littlebitselectronics/HDK-hardware-dev-manual/Design/Templates for PRD/x##-moduleName-PRD.xls

 | This is a Product Requirements Document (PRD) template. The purpose of the PRD is to give engineers a set of features to design to and metrics to determine if a final prototype behaves in an acceptable manner. The information you put here should be closely related to how your prototype works now, and how you want it to work before we ship it. Please delete the contents of this cell, and replace text in RED with your own information. Refer to the examples/ folder if you need an example, and contact us with any questions!
PART NUMBER: | x##-bitName
PRD REVISION: | rev1
PRD CHANGE LOG:
DATE CODE: | DESCRIPTION OF CHANGE: | AUTHOR:
Today's date, formatted like YYMMDD. For example, 4-2-2015 becomes 150402. | Initial revision | Your initials
OVERVIEW:
PRODUCT TYPE: | DESCRIPTION OF PRODUCT: | AUTHOR:
INPUT, OUTPUT, WIRE or POWER. | A brief summary of what the bit does. Should touch on how it interacts with bits before and after it, each mode if it has multiple modes, behavior of any user input (buttons, switches, etc.) and indicators (LEDs, etc.), and anything else you feel is necessary in order to tell someone exactly what should happen when they use the bit. | Your initials
FEATURE LIST:
PRIORITY: | DESCRIPTION OF FEATURE: | AUTHOR: | FEATURE REQUESTED BY:
1 | A more detailed enumeration of each feature described above goes here. Separate them by category (input 1, input 2, output, switch, button, LED, etc…) and prioritize them by what is most essential to the core functionality of the bit. Add as many rows as necessary. | Your initials | Your initials
2
3, etc…
CRITICAL COMPONENTS
PRIORITY: | DESCRIPTION OF FEATURE: | AUTHOR:
1 | A numbered list of all parts critical to the functionality of the Bit that may not be easily substituted or may have long lead times for ordering. | Your initials
2,etc…
MECH. REQUIREMENTS:
PARAMETER: | REQUIREMENT: | AUTHOR:
SIZE: | Bit size. Refer to HDK-eagle-templates-libraries/Eagle Templates for SCH and BRD/Standard Size Reference.pdf. Acceptable values for this field are SMALL, MEDIUM, LARGE, XLARGE, XLARGEWIDE, or XXLARGEWIDE | Your initials
INPUT: | How many input bitSnaps there are. Input bitSnaps are male, so write, for example, ONE MALE BITSNAP | Your initials
OUTPUT: | How many output bitSnaps there are, i.e. ONE FEMALE BITSNAP | Your initials
OTHER: | Any other mechanical considerations, i.e. electrode for alligator clip attachment, motor mount, etc. | Your initials
ELECT. REQUIREMENTS:
PARAMETER: | REQUIREMENT:
INPUT IMPEDANCE: | >=1MEG
OUTPUT IMPEDANCE: | <100OHMS
OUTPUT DYNAMIC RANGE: | 40dB
INPUT DYNAMIC RANGE: | 60dB
IDLE CURRENT: | TBD
MAX CURRENT: | TBD
MAX SUPPLY VOLTAGE: | 5.5
MIN SUPPLY VOLTAGE: | 4
DESIGN REQUIREMENTS:
PARAMETER: | REQUIREMENT: | AUTHOR:
1 | Protection from ESD | GML
2 | Current limiting resistors on IC inputs | GML
3 | Bypass caps on all IC supplies | GML
4 | No bypass caps connected directly to signal line | GML
5 | Ferrite bead in series with Vcc. No components connected directly to external Vcc line. | SMK
6 | Output bitSnap passes input signal through (OUTPUT bits only, remove this for other types) | GML
ACCESSORIES:
QTY: | DESCRIPTION OF ACCESSORY: | AUTHOR:
Quantity required | Any accessories that go with your bit, i.e. interface cable, etc. | Your initials
RELATED PRODUCTS:
PRODUCT: | DESCRIPTION OF RELATIONSHIP: | AUTHOR:
 | Internal use only
LAYOUT PROPOSALS
 | Internal use only
