littlebitselectronics/HDK-hardware-dev-manual/Design/Templates for BOM/x##-moduleName-BOM-XXXXXX.xlsx

Ops PN: | Leave blank
Eng PN: | x##-bitName
Revision | Today's date in the form YYMMDD
Date | Today's date in a more normal format
 |  | This is a Bill of Materials (BOM) template. The purpose of the BOM is to enumerate each component that makes up the PCB assembly (PCBA) of your bit. Anything that is attached to the board in any way goes on the BOM. Please delete the contents of this cell, and replace text in RED with your own information. When you're done, change the six X's at the end of the filename to today's date in the format YYMMDD. Refer to the examples/ folder if you need an example, and contact us with any questions!
ITEM | Ops PN | Description | Rev | Qty Per | MFG | Mfr Part Number | Ref Loc | SUB ALLOWED?
1 |  | Little Bits Connector - Male - Pink (replace this with the proper color if necessary) | v0.3 | 1 | AUK |  | BSM1 | NO
2 |  | Little Bits Connector - Female - Pink (replace this with the proper color if necessary) | v0.3 | 1 | AUK |  | BSF1 | NO
3 |  | DWG PCB, FR4, Lead Free, 2 layer, white solder mask, purple legend | rev1 | 1 | GOLDENSHINE | N/A | N/A | NO
4, etc… | Leave this column blank | Add rows for all of your components. Every distinct manufacturer part number gets its own row. Write a description of the part here. | na | Qty of item per bit | The manufacturer of this component | The manufacturer part number (MPN) of this component | Reference locators for each instance of this component on the board. (i.e. C1, C2, …) | Generally yes for resistors and capacitors, no for most other components
NOTES:
All material is lead-free or RoHs compliant. Supplier to certify compliance and maintain records on all materials purchased.
Any additional notes you need to add go here
REVISION HISTORY
Date | REV | DESCRIPTION
Today's date | Today's date in the form YYMMDD | Initial BOM
APPROVALS
Initials | Date
Don't worry about this section
