littlebitselectronics/HDK-hardware-dev-manual/Design/Eagle Templates for SCH and BRD/Custom Templates/LB_BIT_1IN_2OUT-XXXL-v03(1_1x)-Template/LB_BIT_1IN_2OUT-XXXL-v03(1_1x).brd

## EAGLE design Design/Eagle Templates for SCH and BRD/Custom Templates/LB_BIT_1IN_2OUT-XXXL-v03(1_1x)-Template/LB_BIT_1IN_2OUT-XXXL-v03(1_1x).brd (2014-09-02, last stored version)

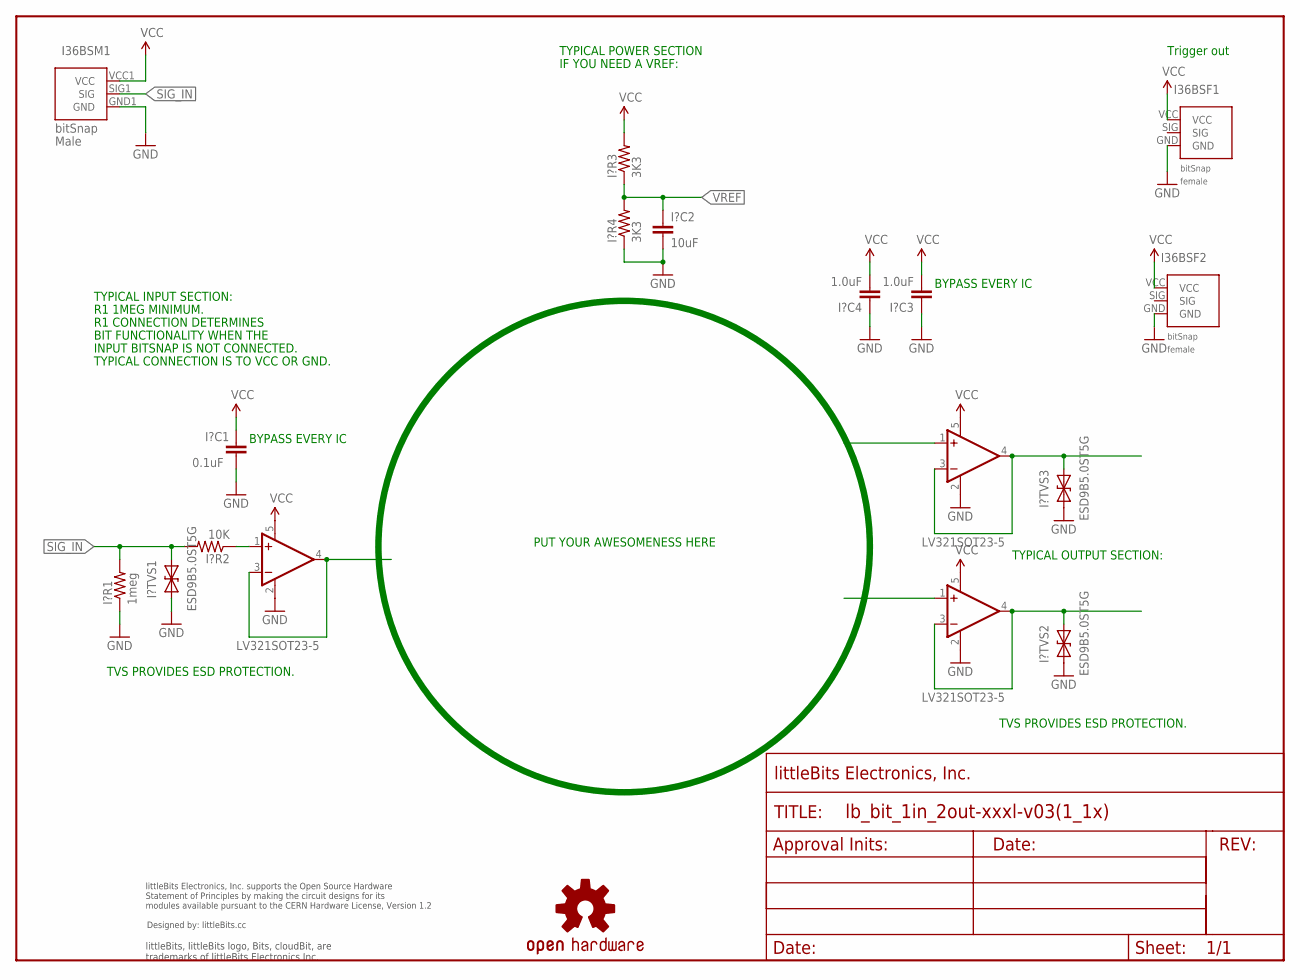
[picture p13: schematic LB_BIT_1IN_2OUT-XXXL-v03(1_1x).sch]

Parts:
FRAME1: FRAME-LETTER; FABDWG01-OHW
I36BSF1, I36BSF2: BITSNAP_V03_FEMALE
I36BSM1: BITSNAP_V03_MALE
I?C1: 0.1uF; CAP-0603
I?C2: 10uF; CAP-0603
I?C3, I?C4: 1.0uF; CAP-0603
I?R1: 1meg; RES-0603
I?R2: 10K; RES-0603
I?R3, I?R4: 3K3; RES-0603
I?TVS1, I?TVS2, I?TVS3: ESD9B5.0ST5G; SOD-923
U1, U2, U3: LV321SOT23-5; SOT23-5
U$1: OSHW-LOGOL; OSHW-LOGO-L
U$3: OSHWCREDIT

Connections:
GND: I36BSF1.GND, I36BSF2.GND, I36BSM1.GND1 (GND), I?C1.2, I?C2.2, I?C3.1, I?C4.1, I?R1.1, I?R4.1, I?TVS1.1 (A), I?TVS2.1 (A), I?TVS3.1 (A), U1.2 (V-), U2.2 (V-), U3.2 (V-)
unnamed: U1.3 (-IN), U1.4 (OUT)
unnamed: I?R2.1, U1.1 (+IN)
SIG_IN: I36BSM1.SIG1 (SIG), I?R1.2, I?R2.2, I?TVS1.2 (C)
SIG_OUT: I?TVS2.2 (C), U2.3 (-IN), U2.4 (OUT)
SIG_OUT1: I?TVS3.2 (C), U3.3 (-IN), U3.4 (OUT)
VCC: I36BSF1.VCC, I36BSF2.VCC, I36BSM1.VCC1 (VCC), I?C1.1, I?C3.2, I?C4.2, I?R3.2, U1.5 (V+), U2.5 (V+), U3.5 (V+)
VREF: I?C2.1, I?R3.1, I?R4.2

Notes on the sheet:
Trigger out
R1 1MEG MINIMUM.
R1 CONNECTION DETERMINES
BIT FUNCTIONALITY WHEN THE
INPUT BITSNAP IS NOT CONNECTED.
TYPICAL CONNECTION IS TO VCC OR GND.
TVS PROVIDES ESD PROTECTION.
TYPICAL INPUT SECTION:
TYPICAL POWER SECTION
IF YOU NEED A VREF:
PUT YOUR AWESOMENESS HERE
BYPASS EVERY IC
TYPICAL OUTPUT SECTION:

Board: 2 copper layers, 21 parts (14 on the bottom side), 8 nets, no tracks yet.

Other parts of the board:
U$17: OSHW_FILLX150_NOTEXT
