littlebitselectronics/HDK-hardware-dev-manual/Design/Eagle Templates for SCH and BRD/Custom Templates/LB_BIT_3IN_3OUT-LARGE-v03(1_1x)-Template/LB_BIT_3IN_3OUT-LARGE-v03(1_1x).brd

## EAGLE design Design/Eagle Templates for SCH and BRD/Custom Templates/LB_BIT_3IN_3OUT-LARGE-v03(1_1x)-Template/LB_BIT_3IN_3OUT-LARGE-v03(1_1x).brd (2014-09-02, last stored version)

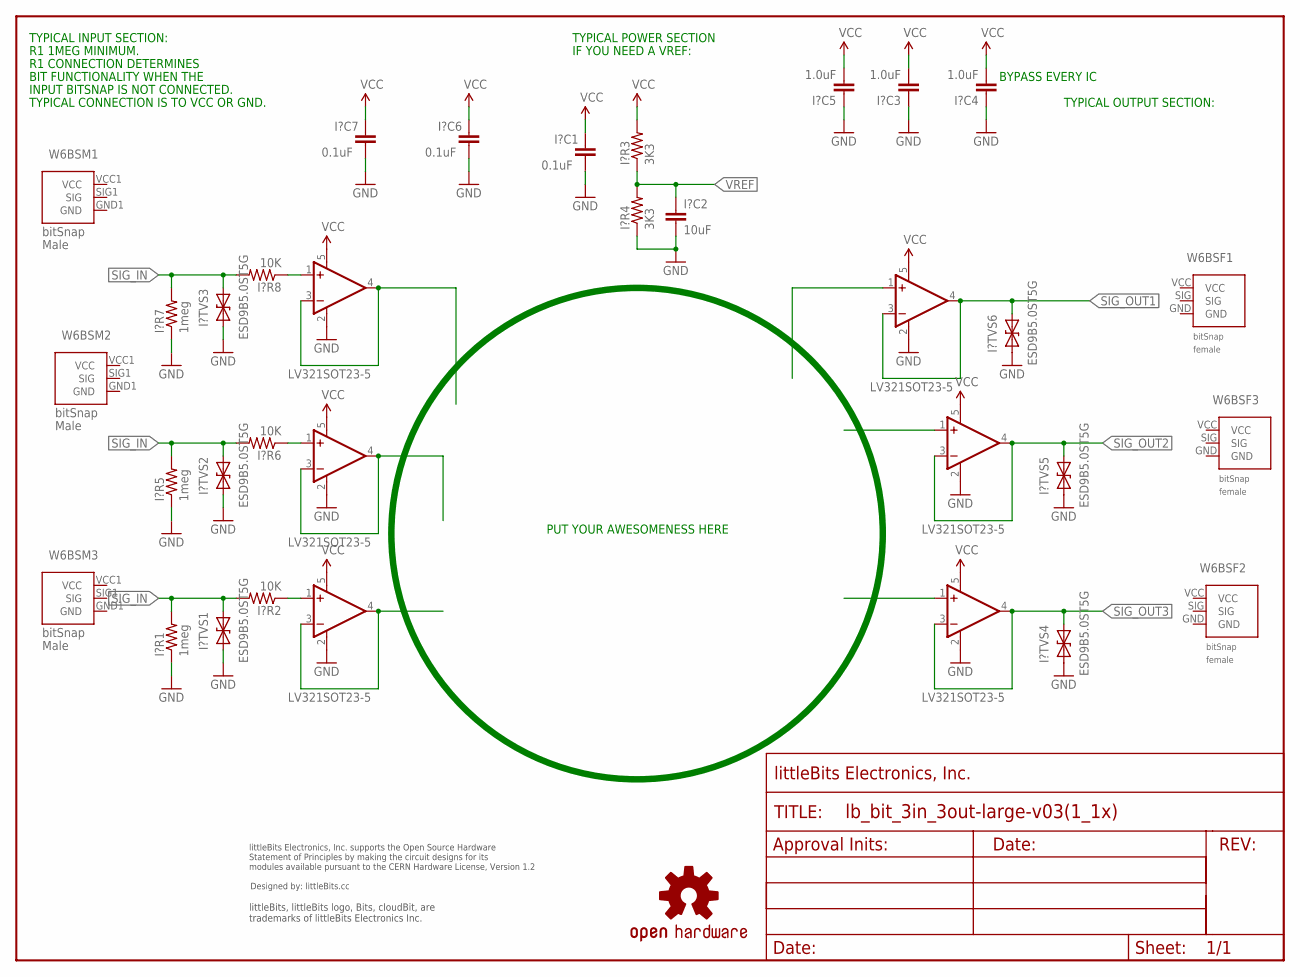
[picture p14: schematic LB_BIT_3IN_3OUT-LARGE-v03(1_1x).sch, i/o filters]

Parts:
FRAME1: FRAME-LETTER; FABDWG01-OHW
I?C1, I?C6, I?C7: 0.1uF; CAP-0603
I?C2: 10uF; CAP-0603
I?C3, I?C4, I?C5: 1.0uF; CAP-0603
I?R1, I?R5, I?R7: 1meg; RES-0603
I?R2, I?R6, I?R8: 10K; RES-0603
I?R3, I?R4: 3K3; RES-0603
I?TVS1, I?TVS2, I?TVS3, I?TVS4, I?TVS5, I?TVS6: ESD9B5.0ST5G; SOD-923
U1, U2, U3, U4, U5, U6: LV321SOT23-5; SOT23-5
U$1: OSHWCREDIT
U$70: OSHW-LOGOL; OSHW-LOGO-L
W6BSF1, W6BSF2, W6BSF3: BITSNAP_V03_FEMALE
W6BSM1, W6BSM2, W6BSM3: BITSNAP_V03_MALE

Connections:
GND: I?C1.2, I?C2.2, I?C3.1, I?C4.1, I?C5.1, I?C6.2, I?C7.2, I?R1.1, I?R4.1, I?R5.1, I?R7.1, I?TVS1.1 (A), I?TVS2.1 (A), I?TVS3.1 (A), I?TVS4.1 (A), I?TVS5.1 (A), I?TVS6.1 (A), U1.2 (V-), U2.2 (V-), U3.2 (V-), U4.2 (V-), U5.2 (V-), U6.2 (V-)
unnamed: I?R2.1, U1.1 (+IN)
unnamed: U1.3 (-IN), U1.4 (OUT)
unnamed: U2.3 (-IN), U2.4 (OUT)
unnamed: I?R6.1, U2.1 (+IN)
unnamed: U3.3 (-IN), U3.4 (OUT)
unnamed: I?R8.1, U3.1 (+IN)
SIG_IN: I?R1.2, I?R2.2, I?R5.2, I?R6.2, I?R7.2, I?R8.2, I?TVS1.2 (C), I?TVS2.2 (C), I?TVS3.2 (C)
SIG_OUT1: I?TVS6.2 (C), U6.3 (-IN), U6.4 (OUT)
SIG_OUT2: I?TVS5.2 (C), U5.3 (-IN), U5.4 (OUT)
SIG_OUT3: I?TVS4.2 (C), U4.3 (-IN), U4.4 (OUT)
VCC: I?C1.1, I?C3.2, I?C4.2, I?C5.2, I?C6.1, I?C7.1, I?R3.2, U1.5 (V+), U2.5 (V+), U3.5 (V+), U4.5 (V+), U5.5 (V+), U6.5 (V+)
VREF: I?C2.1, I?R3.1, I?R4.2

Notes on the sheet:
R1 1MEG MINIMUM.
R1 CONNECTION DETERMINES
BIT FUNCTIONALITY WHEN THE
INPUT BITSNAP IS NOT CONNECTED.
TYPICAL CONNECTION IS TO VCC OR GND.
TYPICAL INPUT SECTION:
TYPICAL POWER SECTION
IF YOU NEED A VREF:
PUT YOUR AWESOMENESS HERE
TYPICAL OUTPUT SECTION:
BYPASS EVERY IC

Board: 2 copper layers, 37 parts (27 on the bottom side), 13 nets, no tracks yet.

Other parts of the board:
U$5: OSHW_FILLX150_NOTEXT
