littlebitselectronics/HDK-hardware-dev-manual/Design/Eagle Templates for SCH and BRD/Custom Templates/LB_BIT_WIRE-v03(1_1x)-Template/LB_BIT_WIRE-v03(1_1x).brd

## EAGLE design Design/Eagle Templates for SCH and BRD/Custom Templates/LB_BIT_WIRE-v03(1_1x)-Template/LB_BIT_WIRE-v03(1_1x).brd (2014-09-02, last stored version)

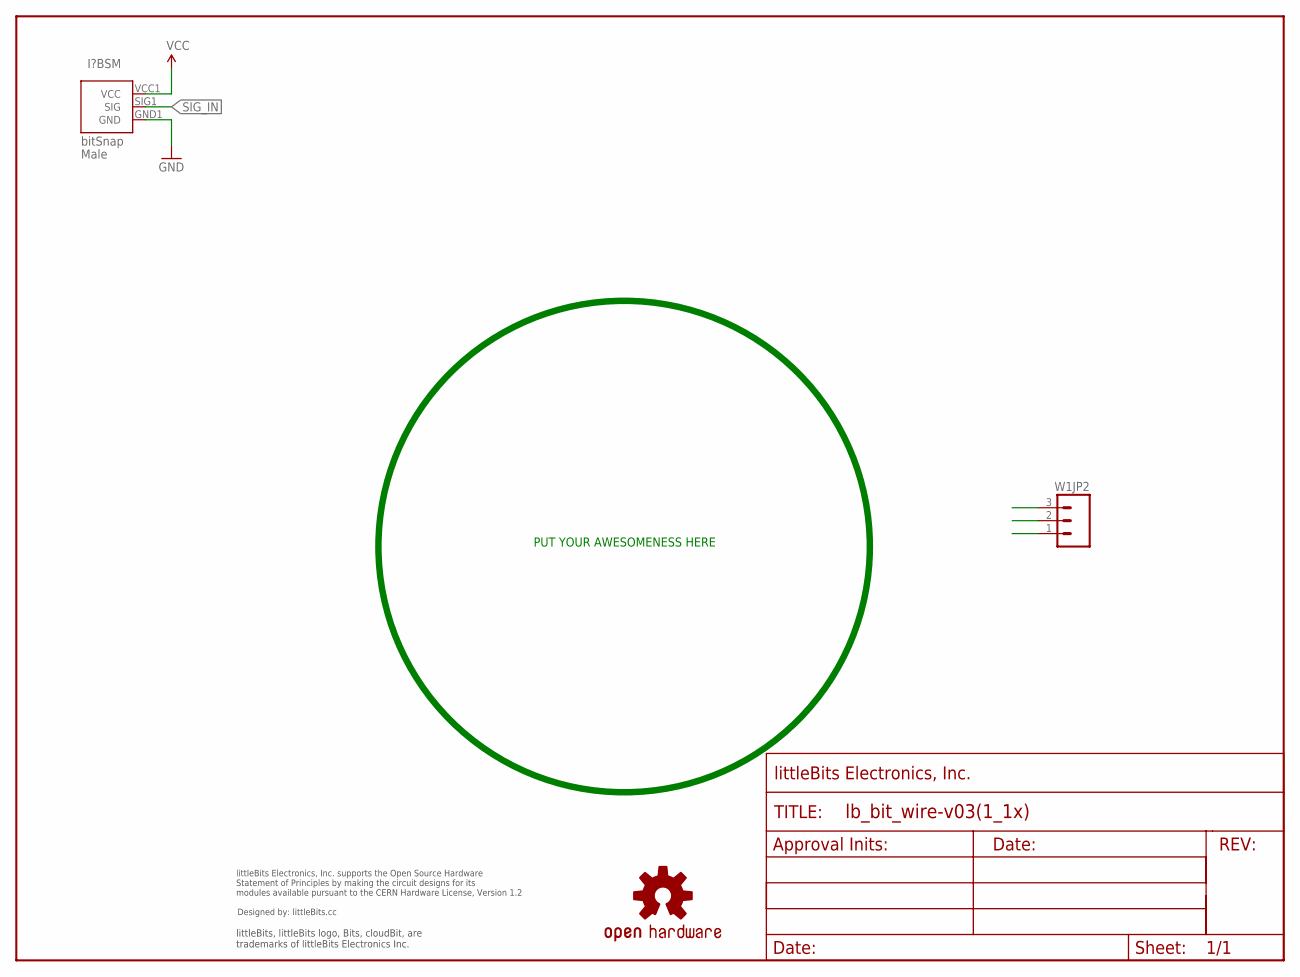
[picture p15: schematic LB_BIT_WIRE-v03(1_1x).sch]

Parts:
FRAME1: FRAME-LETTER; FABDWG01-OHW
I?BSM: BITSNAP_V03_MALE
U$2: OSHWCREDIT
U$5: OSHW-LOGOL; OSHW-LOGO-L
W1JP2: M03SMD; 1X03-1MM-RA

Connections:
GND: I?BSM.GND1 (GND), W1JP2.1
SIG: W1JP2.2
SIG_IN: I?BSM.SIG1 (SIG)
VCC: I?BSM.VCC1 (VCC), W1JP2.3

Notes on the sheet:
PUT YOUR AWESOMENESS HERE

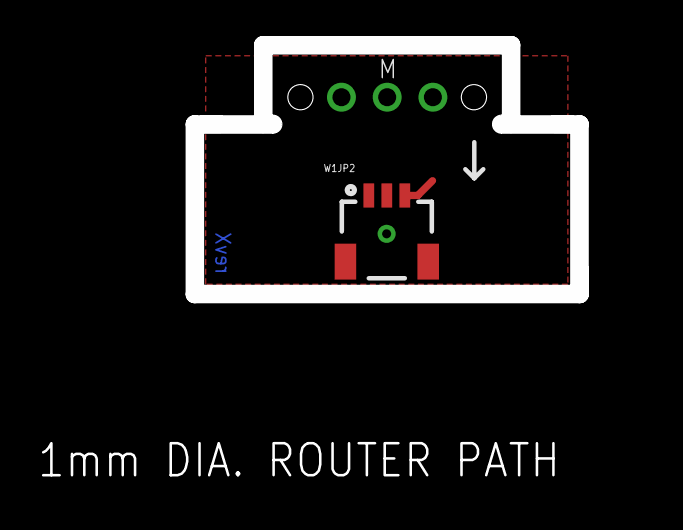
[picture p16: board LB_BIT_WIRE-v03(1_1x).brd from above]

Board: 2 copper layers, 20.4 x 12.8 mm, 6 parts (0 on the bottom side), 2 nets.

Other parts of the board:
U$4: OSHW_FILLX150_NOTEXT
