littlebitselectronics/HDK-hardware-dev-manual/Design/Eagle Templates for SCH and BRD/Custom Templates/LB_BIT_1IN_3OUT-XL-v03(1_1x)-Template/LB_BIT_1IN_3OUT-XL-v03(1_1x).brd

## EAGLE design Design/Eagle Templates for SCH and BRD/Custom Templates/LB_BIT_1IN_3OUT-XL-v03(1_1x)-Template/LB_BIT_1IN_3OUT-XL-v03(1_1x).brd (2014-09-02, last stored version)

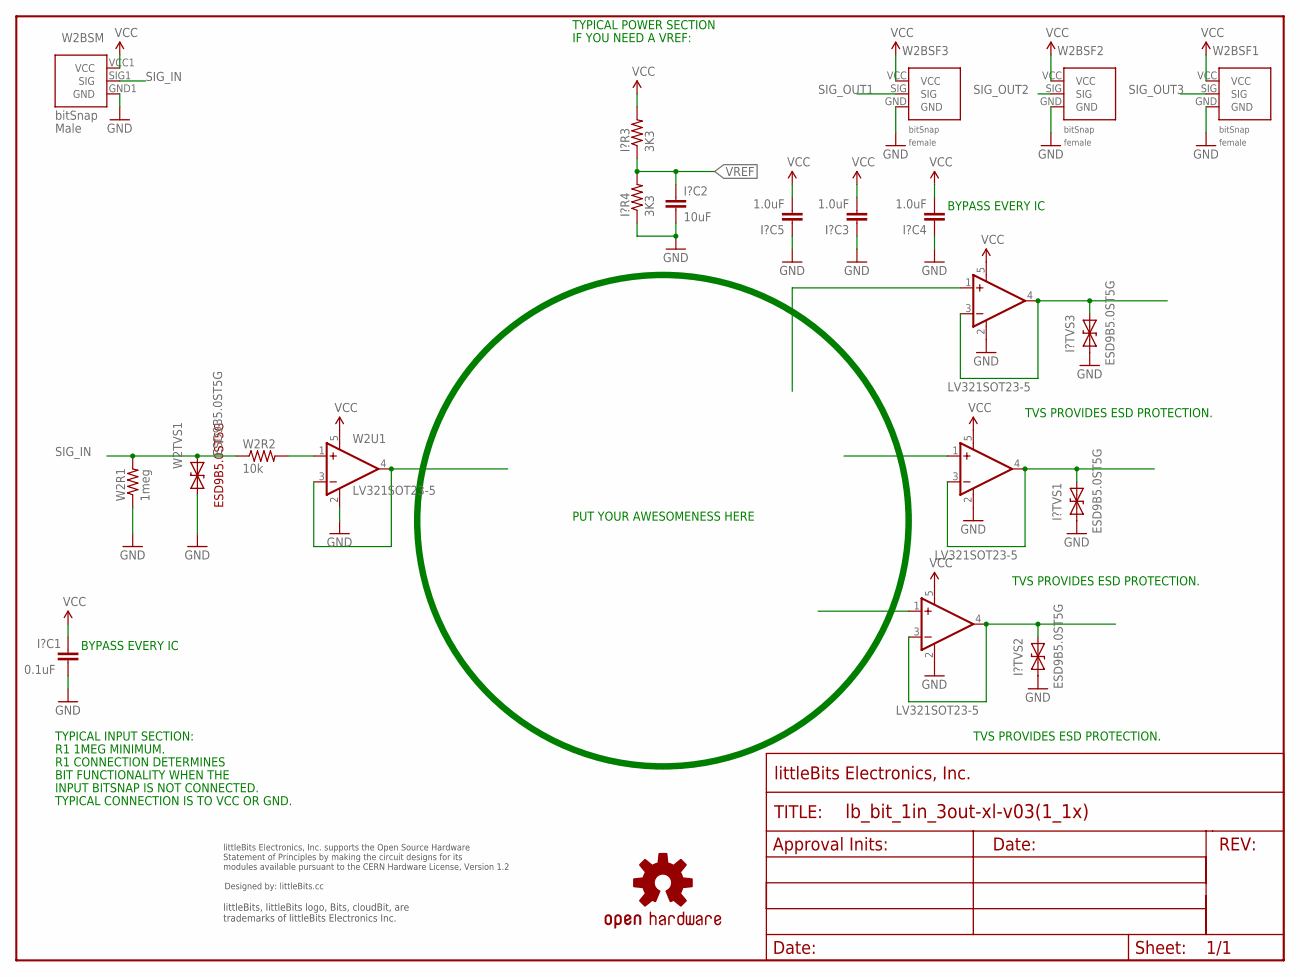
[picture p17: schematic LB_BIT_1IN_3OUT-XL-v03(1_1x).sch]

Parts:
FRAME1: FRAME-LETTER; FABDWG01-OHW
I?C1: 0.1uF; CAP-0603
I?C2: 10uF; CAP-0603
I?C3, I?C4, I?C5: 1.0uF; CAP-0603
I?R3, I?R4: 3K3; RES-0603
I?TVS1, I?TVS2, I?TVS3: ESD9B5.0ST5G; SOD-923
U1, U2, U3: LV321SOT23-5; SOT23-5
U$1: OSHWCREDIT
U$6: OSHW-LOGOL; OSHW-LOGO-L
W2BSF1, W2BSF2, W2BSF3: BITSNAP_V03_FEMALE
W2BSM: BITSNAP_V03_MALE
W2R1: 1meg; RES-0603
W2R2: 10k; RES-0603
W2TVS1: ESD9B5.0ST5G; SOD-923
W2U1: LV321SOT23-5; SOT23-5

Connections:
GND: I?C1.2, I?C2.2, I?C3.1, I?C4.1, I?C5.1, I?R4.1, I?TVS1.1 (A), I?TVS2.1 (A), I?TVS3.1 (A), U1.2 (V-), U2.2 (V-), U3.2 (V-), W2BSF1.GND, W2BSF2.GND, W2BSF3.GND, W2BSM.GND1 (GND), W2R1.1, W2TVS1.1 (A), W2U1.2 (V-)
unnamed: W2U1.3 (-IN), W2U1.4 (OUT)
unnamed: W2R2.2, W2U1.1 (+IN)
SIG_IN: W2BSM.SIG1 (SIG), W2R1.2, W2R2.1, W2TVS1.2 (C)
SIG_OUT1: I?TVS3.2 (C), U3.3 (-IN), U3.4 (OUT), W2BSF3.SIG
SIG_OUT2: I?TVS1.2 (C), U1.3 (-IN), U1.4 (OUT), W2BSF2.SIG
SIG_OUT3: I?TVS2.2 (C), U2.3 (-IN), U2.4 (OUT), W2BSF1.SIG
VCC: I?C1.1, I?C3.2, I?C4.2, I?C5.2, I?R3.2, U1.5 (V+), U2.5 (V+), U3.5 (V+), W2BSF1.VCC, W2BSF2.VCC, W2BSF3.VCC, W2BSM.VCC1 (VCC), W2U1.5 (V+)
VREF: I?C2.1, I?R3.1, I?R4.2

Notes on the sheet:
R1 1MEG MINIMUM.
R1 CONNECTION DETERMINES
BIT FUNCTIONALITY WHEN THE
INPUT BITSNAP IS NOT CONNECTED.
TYPICAL CONNECTION IS TO VCC OR GND.
TYPICAL INPUT SECTION:
TYPICAL POWER SECTION
IF YOU NEED A VREF:
TVS PROVIDES ESD PROTECTION.
PUT YOUR AWESOMENESS HERE
BYPASS EVERY IC

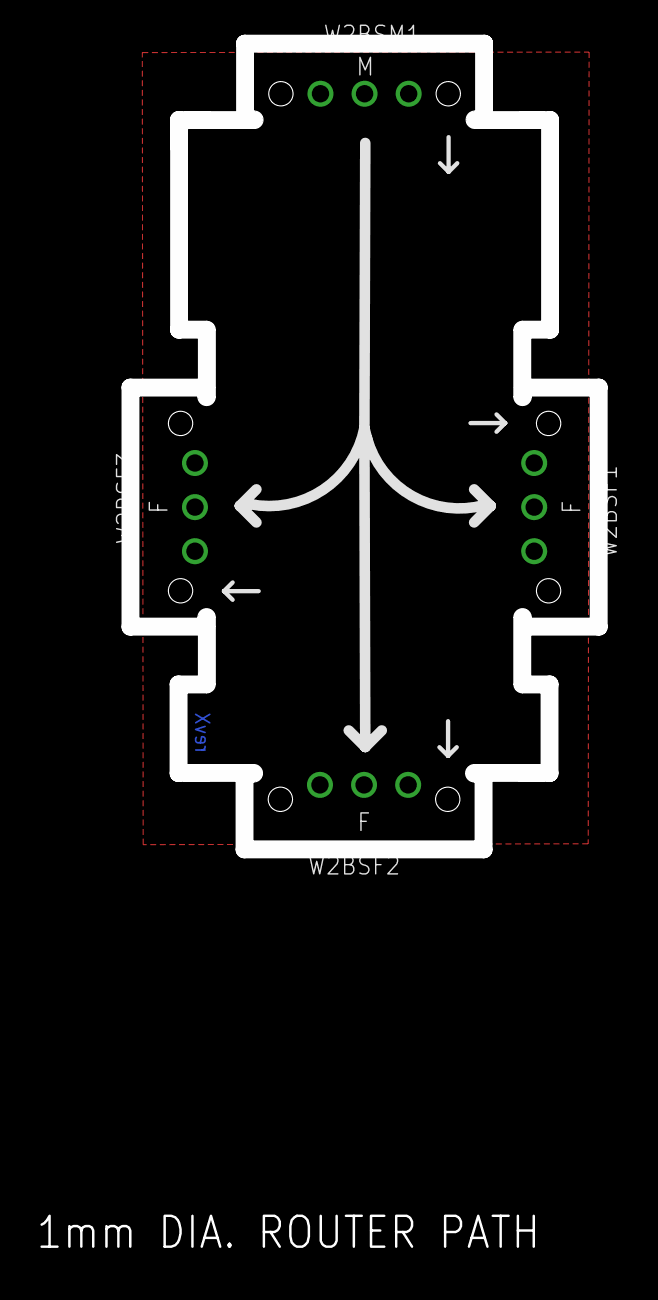
[picture p18: board LB_BIT_1IN_3OUT-XL-v03(1_1x).brd from above]

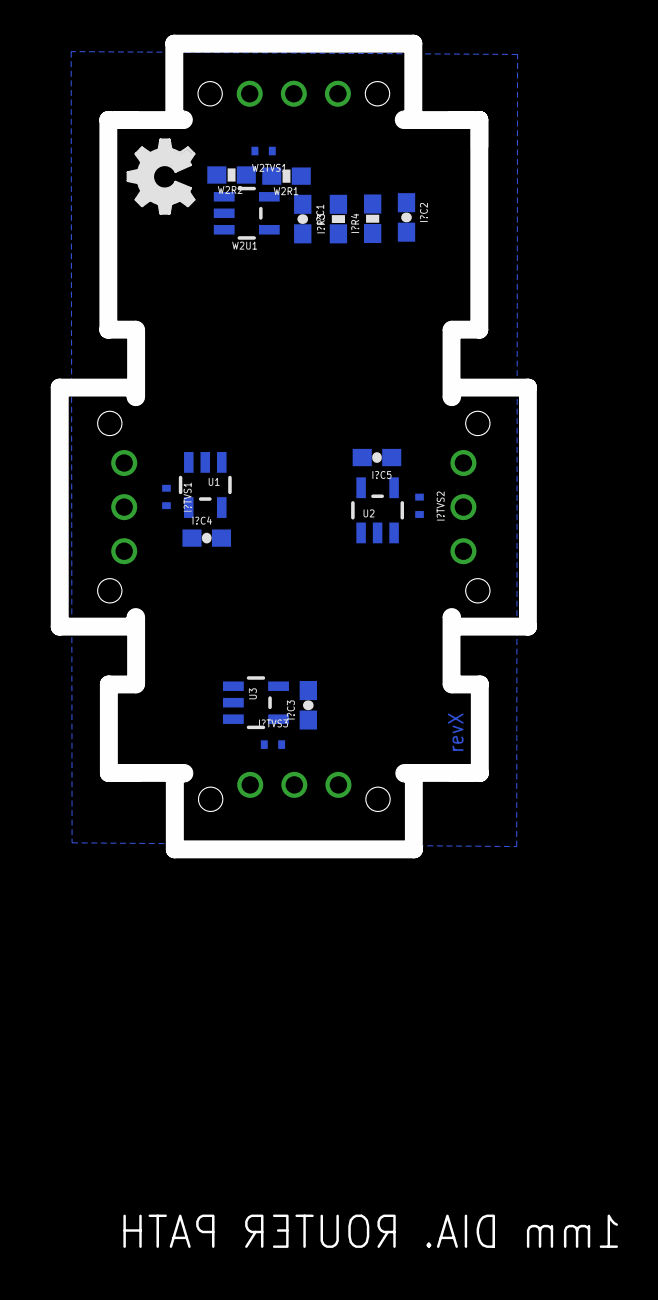
[picture p19: board LB_BIT_1IN_3OUT-XL-v03(1_1x).brd from below]

Board: 2 copper layers, 26.0 x 45.4 mm, 25 parts (17 on the bottom side), 9 nets.

Other parts of the board:
U$5: OSHW_FILLX150_NOTEXT
