littlebitselectronics/HDK-hardware-dev-manual/Design/Eagle Templates for SCH and BRD/Input Templates/LB_BIT_iX_1IN_1OUT-XL-v03(1_1x)-Template/LB_BIT_iX_1IN_1OUT-XL-v03(1_1x).brd

## EAGLE design Design/Eagle Templates for SCH and BRD/Input Templates/LB_BIT_iX_1IN_1OUT-XL-v03(1_1x)-Template/LB_BIT_iX_1IN_1OUT-XL-v03(1_1x).brd (2014-09-02, last stored version)

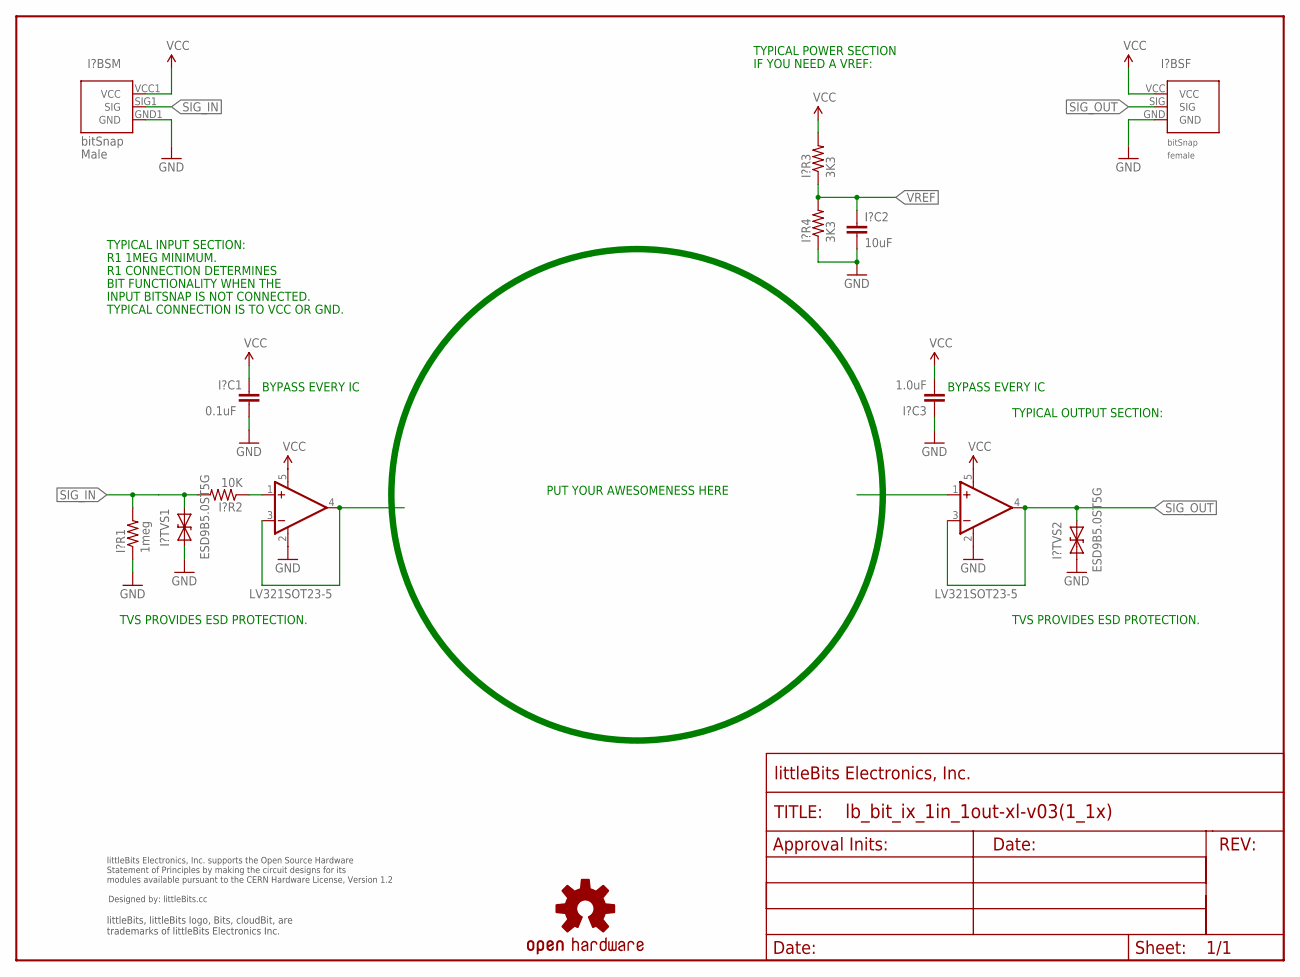
[picture p20: schematic LB_BIT_iX_1IN_1OUT-XL-v03(1_1x).sch]

Parts:
I?BSF: BITSNAP_V03_FEMALE
I?BSM: BITSNAP_V03_MALE
I?C1: 0.1uF; CAP-0603
I?C2: 10uF; CAP-0603
I?C3: 1.0uF; CAP-0603
I?R1: 1meg; RES-0603
I?R2: 10K; RES-0603
I?R3, I?R4: 3K3; RES-0603
I?TVS1, I?TVS2: ESD9B5.0ST5G; SOD-923
U1, U2: LV321SOT23-5; SOT23-5
U$1: OSHW-LOGOL; OSHW-LOGO-L
U$2: FRAME-LETTER; FABDWG01-OHW
U$3: OSHWCREDIT

Connections:
GND: I?C1.2, I?C2.2, I?C3.1, I?R1.1, I?R4.1, I?TVS1.1 (A), I?TVS2.1 (A), U1.2 (V-), U2.2 (V-)
N1: I?BSF.GND, I?BSM.GND1 (GND)
unnamed: U1.3 (-IN), U1.4 (OUT)
unnamed: I?R2.1, U1.1 (+IN)
SIG_IN: I?BSM.SIG1 (SIG), I?R1.2, I?R2.2, I?TVS1.2 (C)
SIG_OUT: I?BSF.SIG, I?TVS2.2 (C), U2.3 (-IN), U2.4 (OUT)
VCC: I?BSF.VCC, I?BSM.VCC1 (VCC), I?C1.1, I?C3.2, I?R3.2, U1.5 (V+), U2.5 (V+)
VREF: I?C2.1, I?R3.1, I?R4.2

Notes on the sheet:
R1 1MEG MINIMUM.
R1 CONNECTION DETERMINES
BIT FUNCTIONALITY WHEN THE
INPUT BITSNAP IS NOT CONNECTED.
TYPICAL CONNECTION IS TO VCC OR GND.
TVS PROVIDES ESD PROTECTION.
TYPICAL INPUT SECTION:
TYPICAL OUTPUT SECTION:
PUT YOUR AWESOMENESS HERE
BYPASS EVERY IC
TYPICAL POWER SECTION
IF YOU NEED A VREF:

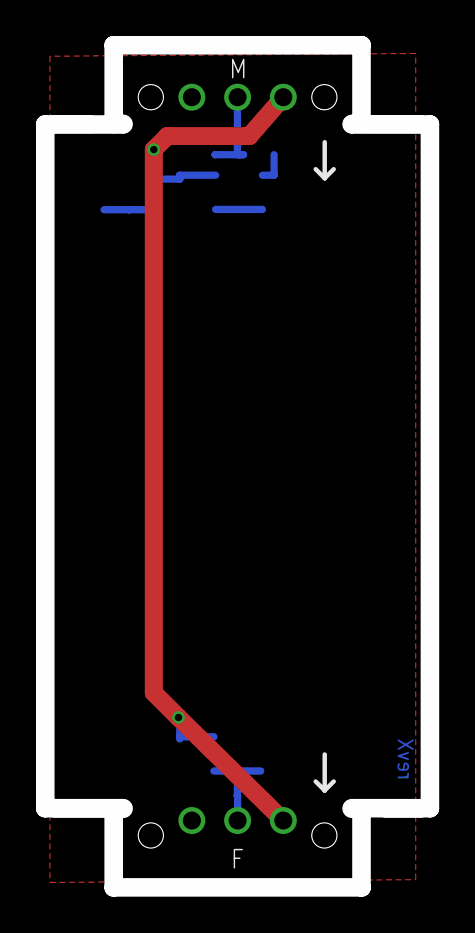
[picture p21: board LB_BIT_iX_1IN_1OUT-XL-v03(1_1x).brd from above]

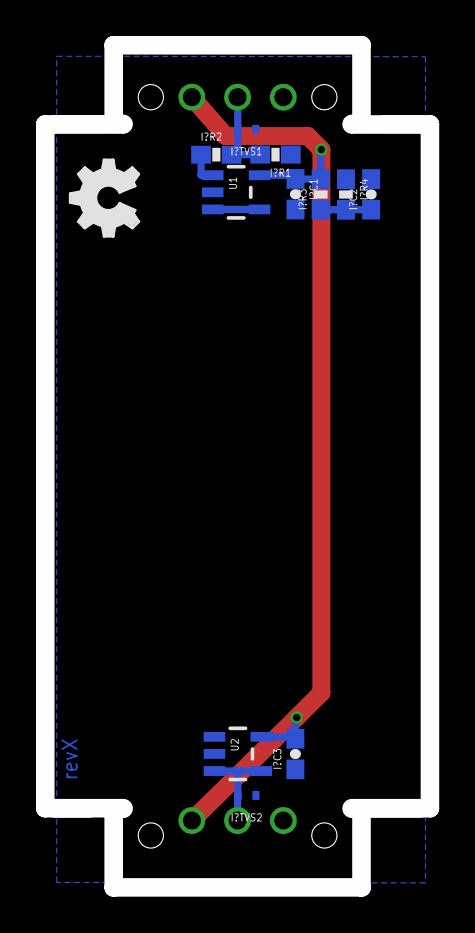
[picture p22: board LB_BIT_iX_1IN_1OUT-XL-v03(1_1x).brd from below]

Board: 2 copper layers, 20.4 x 45.8 mm, 17 parts (12 on the bottom side), 8 nets.

Other parts of the board:
U$4: OSHW_FILLX150_NOTEXT
