littlebitselectronics/HDK-hardware-dev-manual/Design/Eagle Templates for SCH and BRD/Custom Templates/LB_BIT_1OUT-LARGE-v03(1_1x)-Template/LB_BIT_1OUT-LARGE-v03(1_1x).brd

## EAGLE design Design/Eagle Templates for SCH and BRD/Custom Templates/LB_BIT_1OUT-LARGE-v03(1_1x)-Template/LB_BIT_1OUT-LARGE-v03(1_1x).brd (2014-09-02, last stored version)

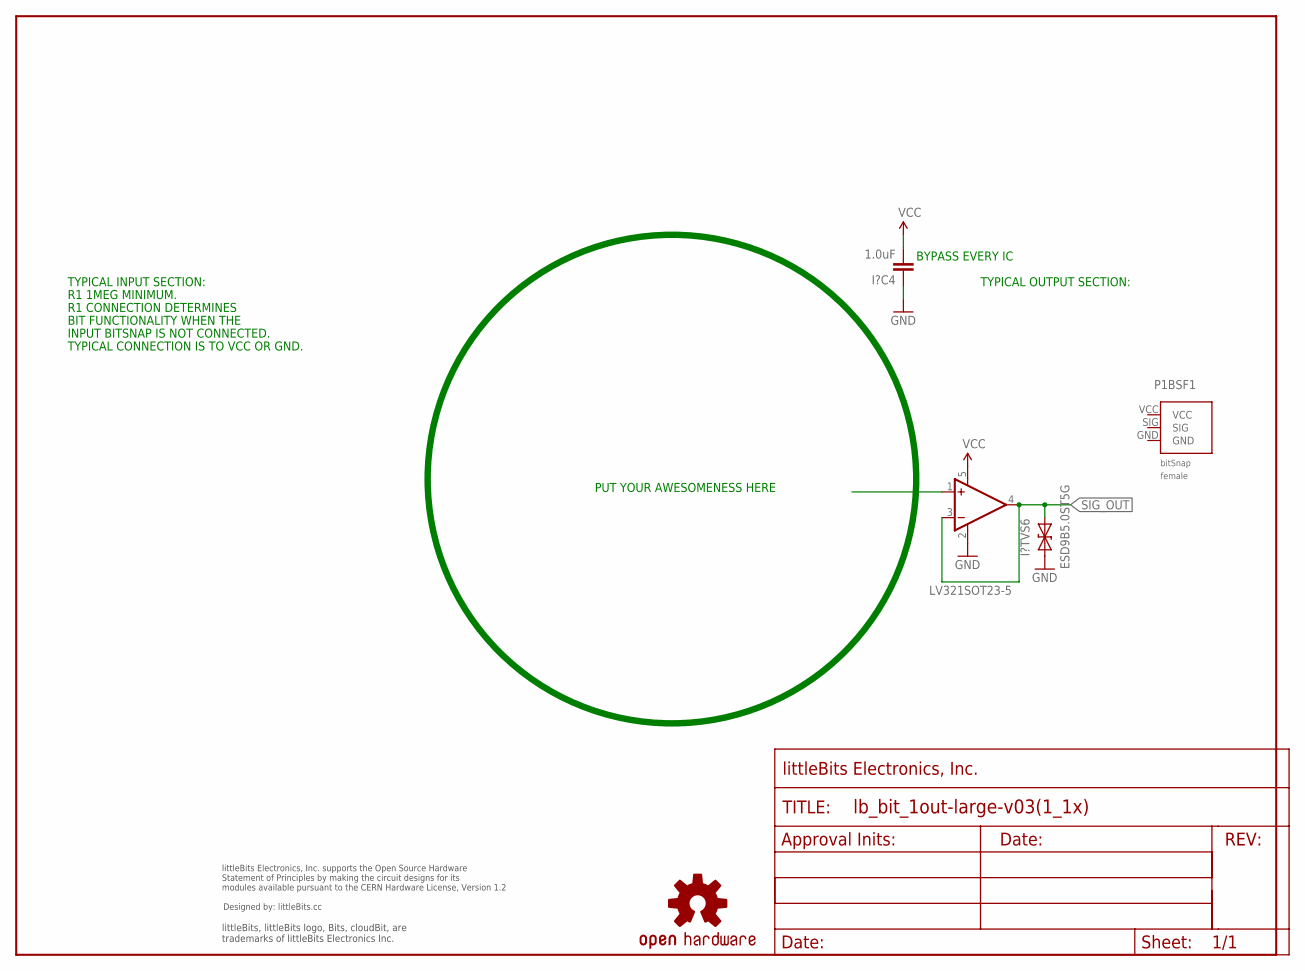
[picture p23: schematic LB_BIT_1OUT-LARGE-v03(1_1x).sch]

Parts:
FRAME1: FRAME-LETTER; FABDWG01-OHW
I?C4: 1.0uF; CAP-0603
I?TVS6: ESD9B5.0ST5G; SOD-923
P1BSF1: BITSNAP_V03_FEMALE
U6: LV321SOT23-5; SOT23-5
U$3: OSHW-LOGOL; OSHW-LOGO-L
U$4: OSHWCREDIT

Connections:
GND: I?C4.1, I?TVS6.1 (A), U6.2 (V-)
SIG_OUT: I?TVS6.2 (C), U6.3 (-IN), U6.4 (OUT)
VCC: I?C4.2, U6.5 (V+)

Notes on the sheet:
R1 1MEG MINIMUM.
R1 CONNECTION DETERMINES
BIT FUNCTIONALITY WHEN THE
INPUT BITSNAP IS NOT CONNECTED.
TYPICAL CONNECTION IS TO VCC OR GND.
TYPICAL INPUT SECTION:
PUT YOUR AWESOMENESS HERE
TYPICAL OUTPUT SECTION:
BYPASS EVERY IC

Board: 2 copper layers, 9 parts (3 on the bottom side), 3 nets, no tracks yet.

Other parts of the board:
U$2: OSHW_FILLX150_NOTEXT
U$12: LB_PWR_LEGS
