littlebitselectronics/HDK-hardware-dev-manual/(commit log)

2014-09-02 Added HDK files
    [EVTtestForm02.xlsx, LB_BIT_1IN_1OUT-XXLWIDE-v03(1_1x).brd, LB_BIT_1IN_1OUT-XXLWIDE-v03(1_1x).sch, LB_BIT_1IN_2OUT-XL-v03(1_1x).brd, LB_BIT_1IN_2OUT-XL-v03(1_1x).sch, LB_BIT_1IN_2OUT-XXXL-v03(1_1x).brd, LB_BIT_1IN_2OUT-XXXL-v03(1_1x).sch, LB_BIT_1IN_3OUT-MEDIUM-v03(1_1x).brd]
2014-09-03 Removed MFG files and put them in separate Repo
    [EVTtestForm02.xlsx, LB_BIT_iX-INPUTTEMPLATE_v03_BOM_revA.xlsx, LB_BIT_oX-OUTPUTTEMPLATE_v03_BOM_revA.xlsx]
2014-09-08 Templates and libraries moved to another folder.
    [LB_BIT_1IN_1OUT-XXLWIDE-v03(1_1x).brd, LB_BIT_1IN_1OUT-XXLWIDE-v03(1_1x).sch, LB_BIT_1IN_2OUT-XL-v03(1_1x).brd, LB_BIT_1IN_2OUT-XL-v03(1_1x).sch, LB_BIT_1IN_2OUT-XXXL-v03(1_1x).brd, LB_BIT_1IN_2OUT-XXXL-v03(1_1x).sch, LB_BIT_1IN_3OUT-MEDIUM-v03(1_1x).brd, LB_BIT_1IN_3OUT-MEDIUM-v03(1_1x).sch]
2014-09-11 Updated HDK with correct file locations, added BOM template
    [LB_BIT_iX-INPUTTEMPLATE_v03_BOM_revA.xlsx, LB_BIT_oX-OUTPUTTEMPLATE_v03_BOM_revA.xlsx, prd_template.xls]
2014-09-16 -Added UI Consideration doc -Updated Welcom Developers doc -Updated logo in PRD template doc -Created PDFs of docs
    [prd_template.xls]
2015-04-17 Update HDK materials 17-Apr-2015
    [LB_BIT_iX-INPUTTEMPLATE_v03_BOM_revA.xlsx, LB_BIT_oX-OUTPUTTEMPLATE_v03_BOM_revA.xlsx, prd_template.xls, x##-moduleName-BOM-XXXXXX.xlsx, x##-moduleName-PRD.xls]
