littlebitselectronics/HDK-hardware-dev-manual/(notices)

Notices in the files:
parts and their libraries:
LITTLEBITS: modules available pursuant to the CERN Hardware License,
Version 1.2
LITTLEBITS: modules available pursuant to the CERN Hardware License, Version 1.2
SparkFun_NEW: Licensing: CC v3.0 Share-Alike You are welcome to use this library for commercial purposes.
